maui-i/diy-distortion-pedal/docs/images/pcb-3d-bottom.png

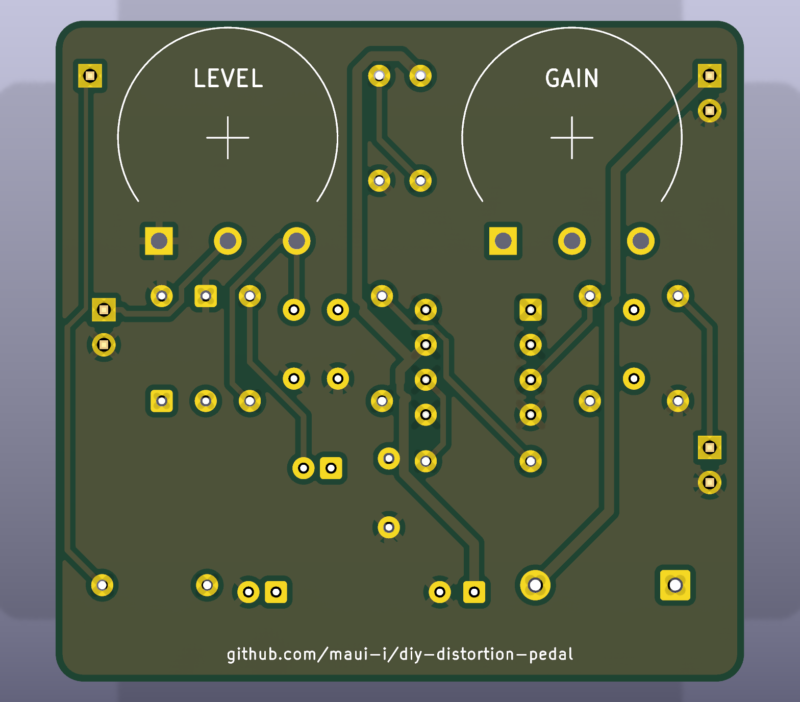
docs/images/pcb-3d-bottom.png
