maui-i/diy-distortion-pedal/hardware/fabrication/bom.csv

Refs | Value | Footprint | Qty
BT1 | 9V |  | 1
C1 | 10n | Capacitor_THT:C_Rect_L7.2mm_W2.5mm_P5.00mm_FKS2_FKP2_MKS2_MKP2 | 1
C2 | 47n | Capacitor_THT:C_Rect_L7.2mm_W2.5mm_P5.00mm_FKS2_FKP2_MKS2_MKP2 | 1
C3 | 1u | Capacitor_THT:CP_Radial_D5.0mm_P2.00mm | 1
C4 | 1n | Capacitor_THT:C_Rect_L7.2mm_W2.5mm_P5.00mm_FKS2_FKP2_MKS2_MKP2 | 1
C5 | 100u | Capacitor_THT:CP_Radial_D6.3mm_P2.50mm | 1
C6 | 100n | Capacitor_THT:C_Disc_D5.0mm_W2.5mm_P5.00mm | 1
C7 | 10u | Capacitor_THT:CP_Radial_D5.0mm_P2.00mm | 1
D1,D2 | 1N34A | Diode_THT:D_DO-35_SOD27_P7.62mm_Horizontal | 2
D3 | 1N5817 | Diode_THT:D_DO-41_SOD81_P10.16mm_Horizontal | 1
D4 | LED |  | 1
IC1 | TL071 | Package_DIP:DIP-8_W7.62mm_Socket | 1
J1 | IN | Connector_PinHeader_2.54mm:PinHeader_1x02_P2.54mm_Vertical | 1
J2 | OUT | Connector_PinHeader_2.54mm:PinHeader_1x02_P2.54mm_Vertical | 1
J3 | 9V IN | Connector_PinHeader_2.54mm:PinHeader_1x02_P2.54mm_Vertical | 1
J4 | LED+ | Connector_PinHeader_2.54mm:PinHeader_1x01_P2.54mm_Vertical | 1
J5 | Input jack |  | 1
J6 | Output jack |  | 1
J7 | DC jack |  | 1
R1-R3 | 1M | Resistor_THT:R_Axial_DIN0207_L6.3mm_D2.5mm_P7.62mm_Horizontal | 3
R4,R8 | 4.7k | Resistor_THT:R_Axial_DIN0207_L6.3mm_D2.5mm_P7.62mm_Horizontal | 2
R5 | 10k | Resistor_THT:R_Axial_DIN0207_L6.3mm_D2.5mm_P7.62mm_Horizontal | 1
R6,R7 | 100k | Resistor_THT:R_Axial_DIN0207_L6.3mm_D2.5mm_P7.62mm_Horizontal | 2
RV1 | C1M (GAIN) | pedal:Pot_16mm_PCB | 1
RV2 | A10K (LEVEL) | pedal:Pot_16mm_PCB | 1
SW1 | 3PDT footswitch |  | 1
