maui-i/diy-distortion-pedal/hardware/schematic.pdf

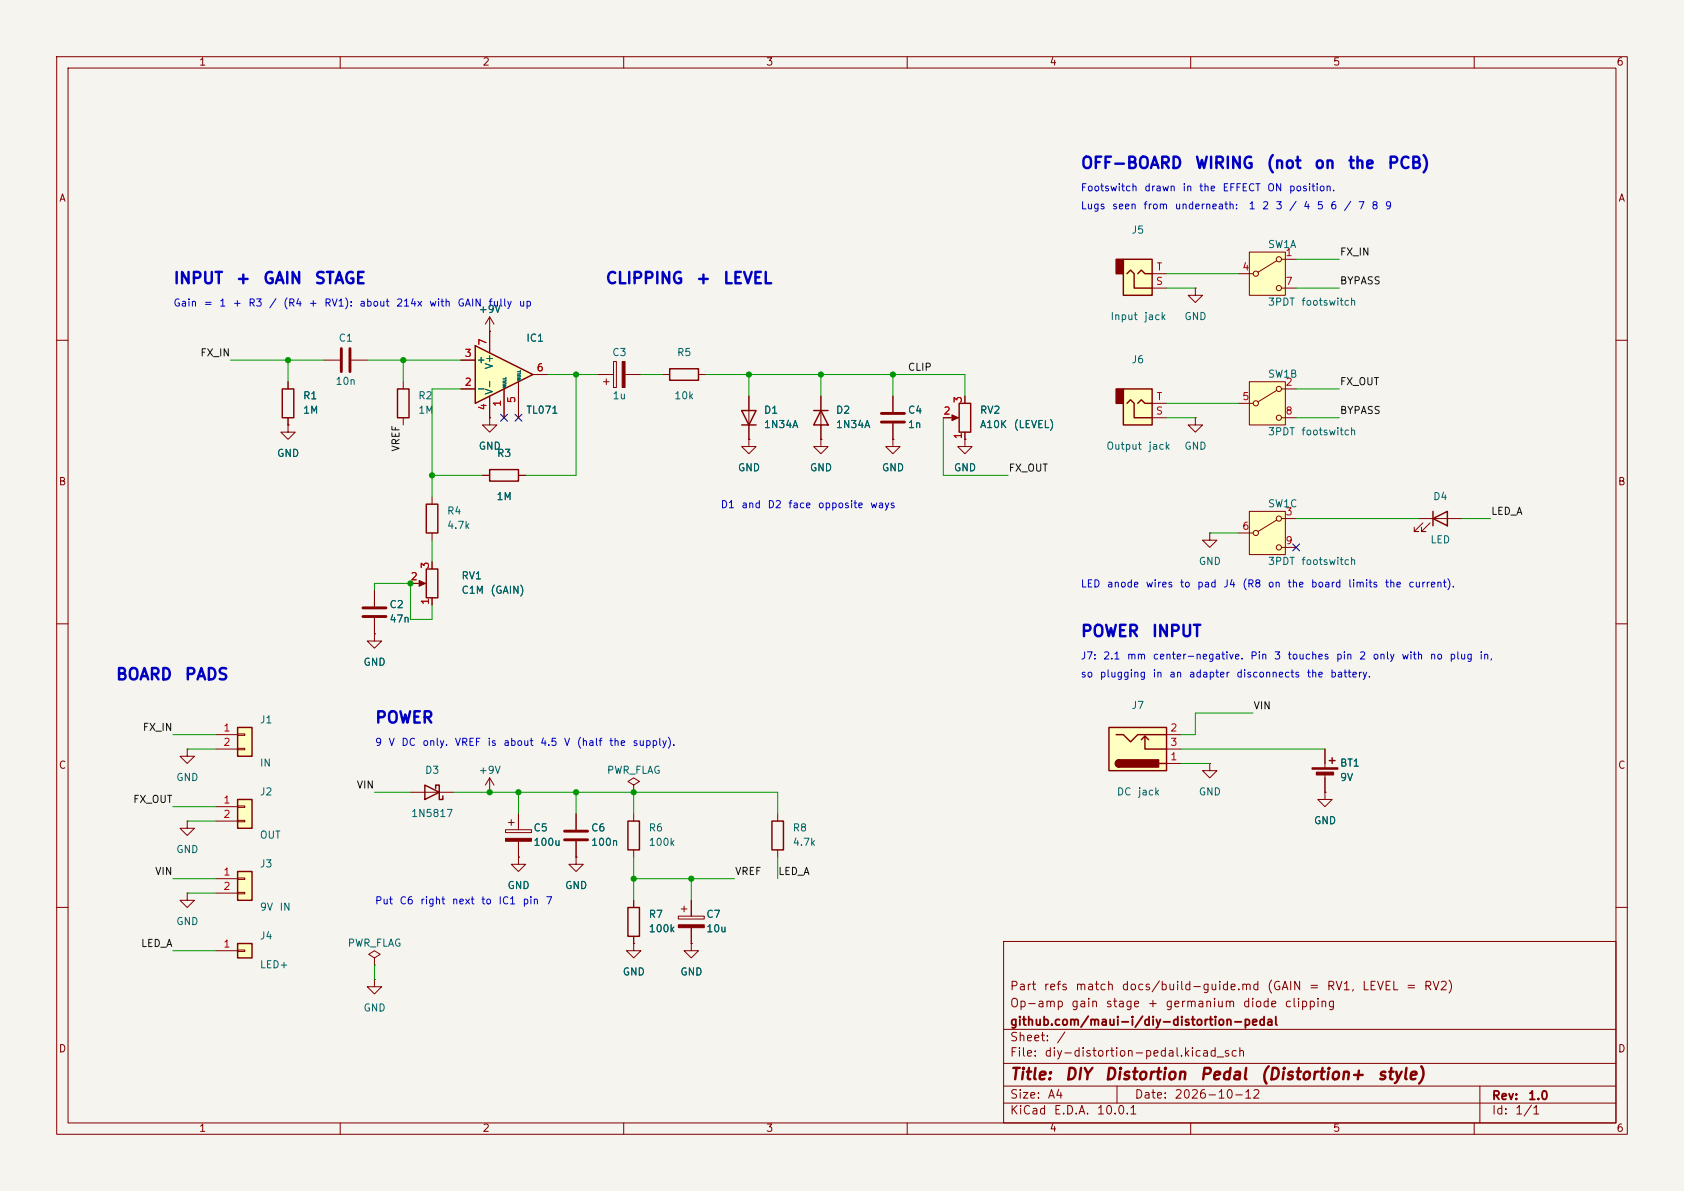
[picture p4: page 1]

OFF-BOARD WIRING (not on the PCB)
9V GND

Footswitch drawn in the EFFECT ON position.

Lugs seen from underneath: 1 2 3 / 4 5 6 / 7 8 9

D1 and D2 face opposite ways Gain = 1 + R3 / (R4 + RV1): about 214x with GAIN fully up

LED anode wires to pad J4 (R8 on the board limits the current). 9 V DC only. VREF is about 4.5 V (half the supply). Put C6 right next to IC1 pin 7 RV1 C1M (GAIN) 1

so plugging in an adapter disconnects the battery. J7: 2.1 mm center-negative. Pin 3 touches pin 2 only with no plug in,

Part refs match docs/build-guide.md (GAIN = RV1, LEVEL = RV2) C5

Op-amp gain stage + germanium diode clipping
github.com/maui-i/diy-distortion-pedal
Sheet: /
File: diy-distortion-pedal.kicad_sch
Title: DIY Distortion Pedal (Distortion+ style)

Size: A4 | Rev: 1.0
KiCad E.D.A. 10.0.1 | Id: 1/1
