maui-i/diy-distortion-pedal/hardware/fabrication/assembly-top.pdf

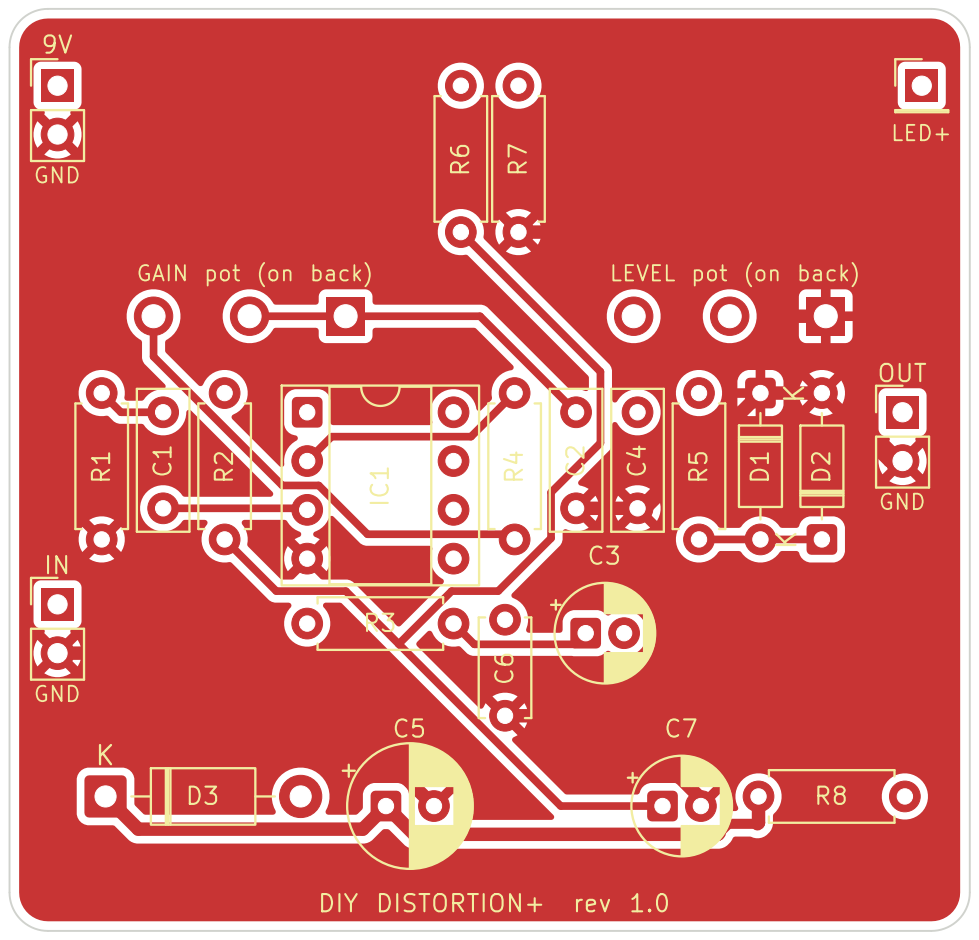
[picture p5: page 1]
