maui-i/diy-distortion-pedal/hardware/kicad/diy-distortion-pedal.kicad_pcb

## KiCad design hardware/kicad/diy-distortion-pedal.kicad_pcb (2026-10-12)

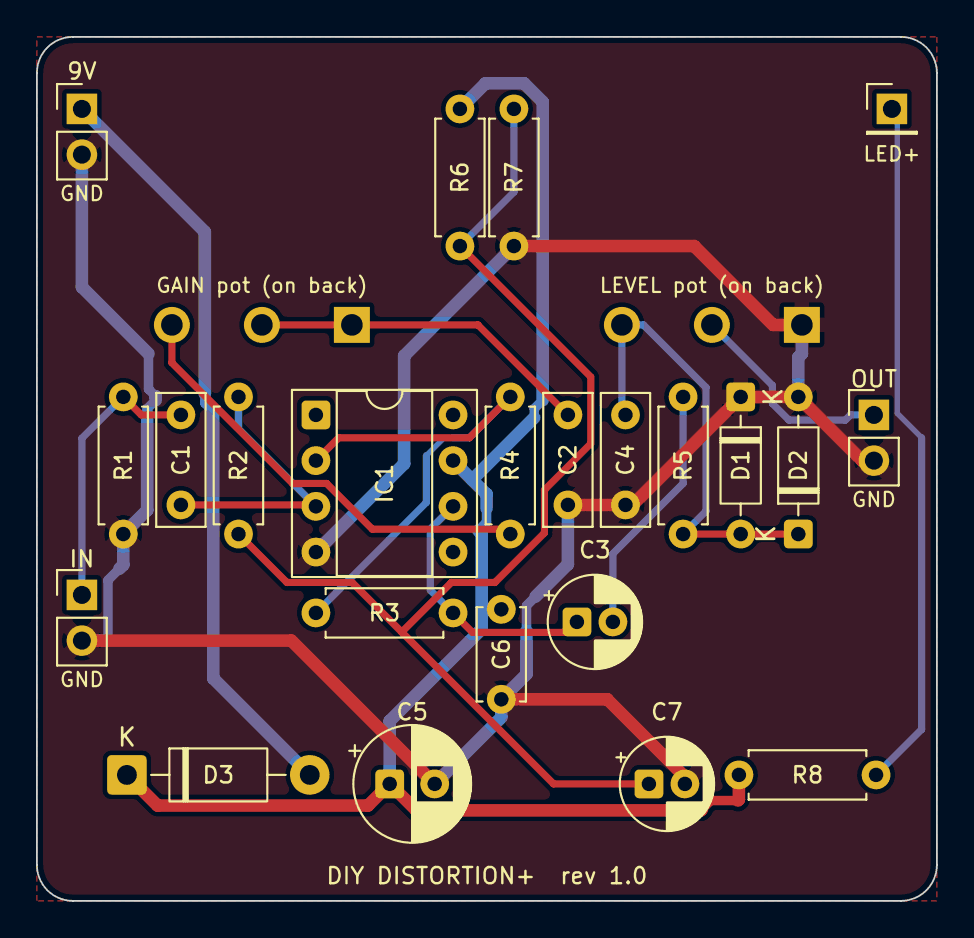
[picture p6: board diy-distortion-pedal.kicad_pcb from above]

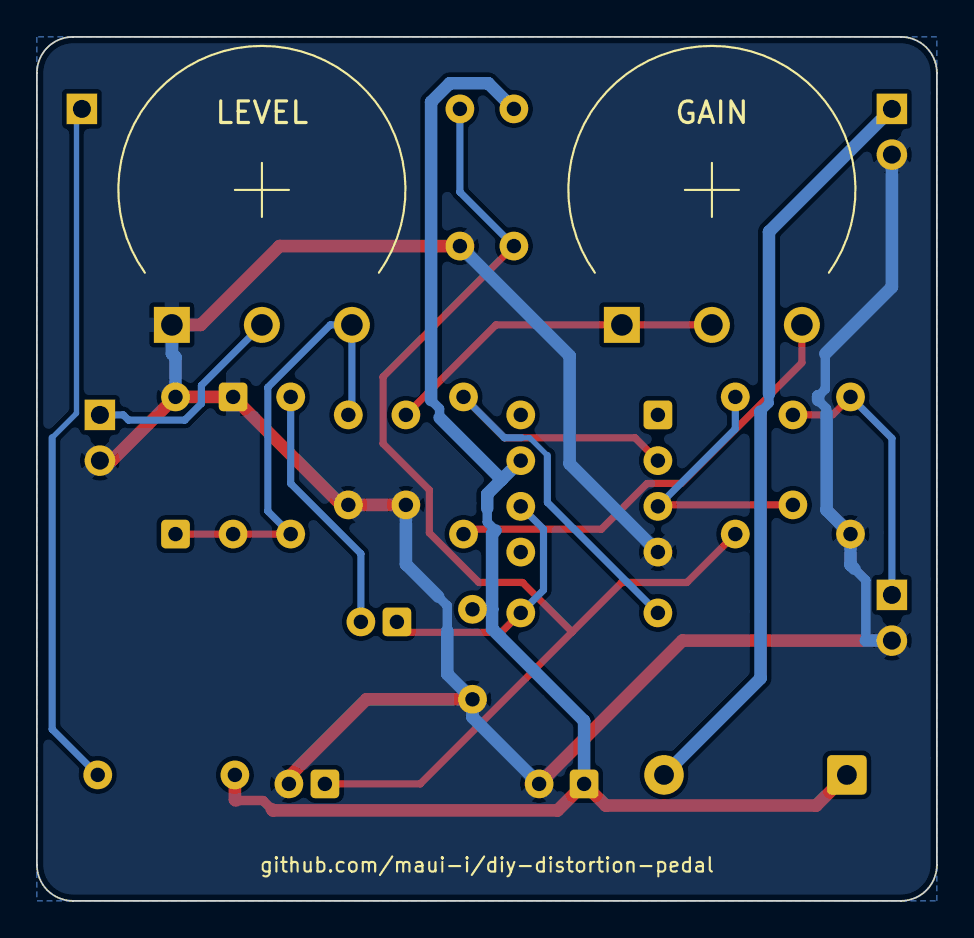
[picture p7: board diy-distortion-pedal.kicad_pcb from below]

Board: 2 copper layers, 50.0 x 48.0 mm, 25 parts (2 on the bottom side), 14 nets.

Parts:
C1: 10n; C_Rect_L7.2mm_W2.5mm_P5.00mm_FKS2_FKP2_MKS2_MKP2
C2: 47n; C_Rect_L7.2mm_W2.5mm_P5.00mm_FKS2_FKP2_MKS2_MKP2
C3: 1u; CP_Radial_D5.0mm_P2.00mm
C4: 1n; C_Rect_L7.2mm_W2.5mm_P5.00mm_FKS2_FKP2_MKS2_MKP2
C5: 100u; CP_Radial_D6.3mm_P2.50mm
C6: 100n; C_Disc_D5.0mm_W2.5mm_P5.00mm
C7: 10u; CP_Radial_D5.0mm_P2.00mm
D1, D2: 1N34A; D_DO-35_SOD27_P7.62mm_Horizontal
D3: 1N5817; D_DO-41_SOD81_P10.16mm_Horizontal
IC1: TL071; DIP-8_W7.62mm_Socket
J1: IN; PinHeader_1x02_P2.54mm_Vertical
J2: OUT; PinHeader_1x02_P2.54mm_Vertical
J3: 9V IN; PinHeader_1x02_P2.54mm_Vertical
J4: LED+; PinHeader_1x01_P2.54mm_Vertical
R1, R2, R3: 1M; R_Axial_DIN0207_L6.3mm_D2.5mm_P7.62mm_Horizontal
R4, R8: 4.7k; R_Axial_DIN0207_L6.3mm_D2.5mm_P7.62mm_Horizontal
R5: 10k; R_Axial_DIN0207_L6.3mm_D2.5mm_P7.62mm_Horizontal
R6, R7: 100k; R_Axial_DIN0207_L6.3mm_D2.5mm_P7.62mm_Horizontal
RV1: C1M (GAIN); Pot_16mm_PCB
RV2: A10K (LEVEL); Pot_16mm_PCB

Connections:
+9V: C5.1, C6.1, D3.1, IC1.7, R6.1, R8.1
/CLIP: C4.1, D1.2, D2.1, R5.2, RV2.3
/FX_IN: C1.1, J1.1, R1.1
/FX_OUT: J2.1, RV2.2
/LED_A: J4.1, R8.2
/VIN: D3.2, J3.1
/VREF: C7.1, R2.2, R6.2, R7.1
GND: C2.2, C4.2, C5.2, C6.2, C7.2, D1.1, D2.2, IC1.4, J1.2, J2.2, J3.2, R1.2, R7.2, RV2.1
unnamed: C2.1, RV1.1, RV1.2
unnamed: C3.1, IC1.6, R3.2
unnamed: C3.2, R5.1
unnamed: C1.2, IC1.3, R2.1
unnamed: IC1.2, R3.1, R4.1
unnamed: R4.2, RV1.3
